quietguy675/RFID_Door_Entry/README.md

# RFID_Door_Entry
Arduino-based system which interacts with an HID reader, a SD card shield, and an electric door strike
