quietguy675/RFID_Door_Entry/RFID_Eagle_Files/RFID/RFID.brd

## EAGLE design RFID_Eagle_Files/RFID/RFID.brd (2017-01-27)

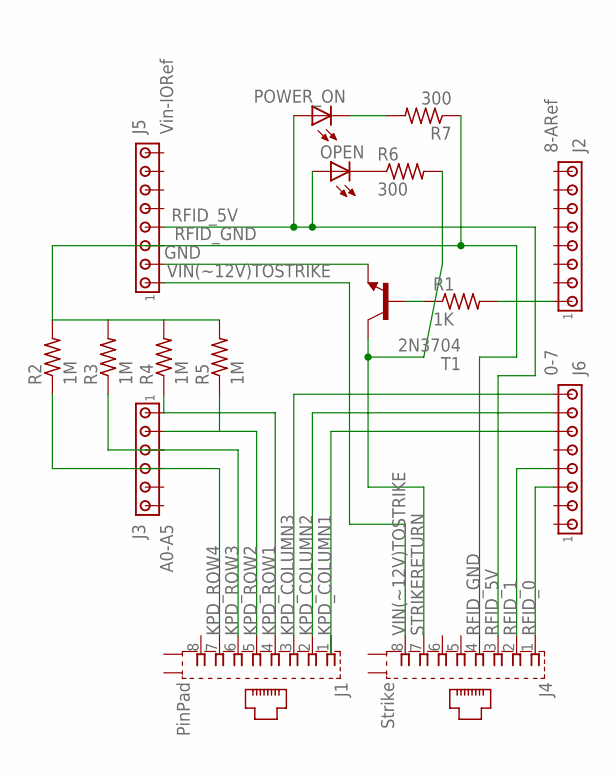
[picture p1: schematic RFID.sch]

Parts:
J1: PinPad; 556591-1
J2: 8-ARef; 1X8MTA
J3: A0-A5; 10X06MTA
J4: Strike; 556591-1
J5: Vin-IORef; 1X8MTA
J6: 0-7; 1X8MTA
OPEN: LED3MM
POWER_ON: LED3MM
R1: 1K; 0204/5
R2, R3, R4, R5: 1M; 0204/5
R6, R7: 300; 0204/5
T1: 2N3704; TO92

Connections:
GND: J5.2, T1.3 (E)
KPD_COLUMN1: J6.6
KPD_COLUMN2: J1.2, J6.7
KPD_COLUMN3: J1.3, J6.8
KPD_ROW1: J1.4, J3.6 (1), R4.1
KPD_ROW2: J1.5, J3.5 (2), R5.1
KPD_ROW3: J1.6, J3.4 (3), R3.1
KPD_ROW4: J1.7, J3.3 (4), R2.1
unnamed: J2.1, R1.2
unnamed: R1.1, T1.1 (B)
unnamed: OPEN.K (C), R6.1
unnamed: POWER_ON.K (C), R7.2
RFID_0: J4.1, J6.3
RFID_1: J4.2, J6.4
RFID_5V: J4.3, J5.4, OPEN.A, POWER_ON.A
RFID_GND: J4.4, J5.3, R2.2, R3.2, R4.2, R5.2, R7.1
STRIKERETURN: J4.7, R6.2, T1.2 (C)
VIN(~12V)TOSTRIKE: J4.8, J5.1

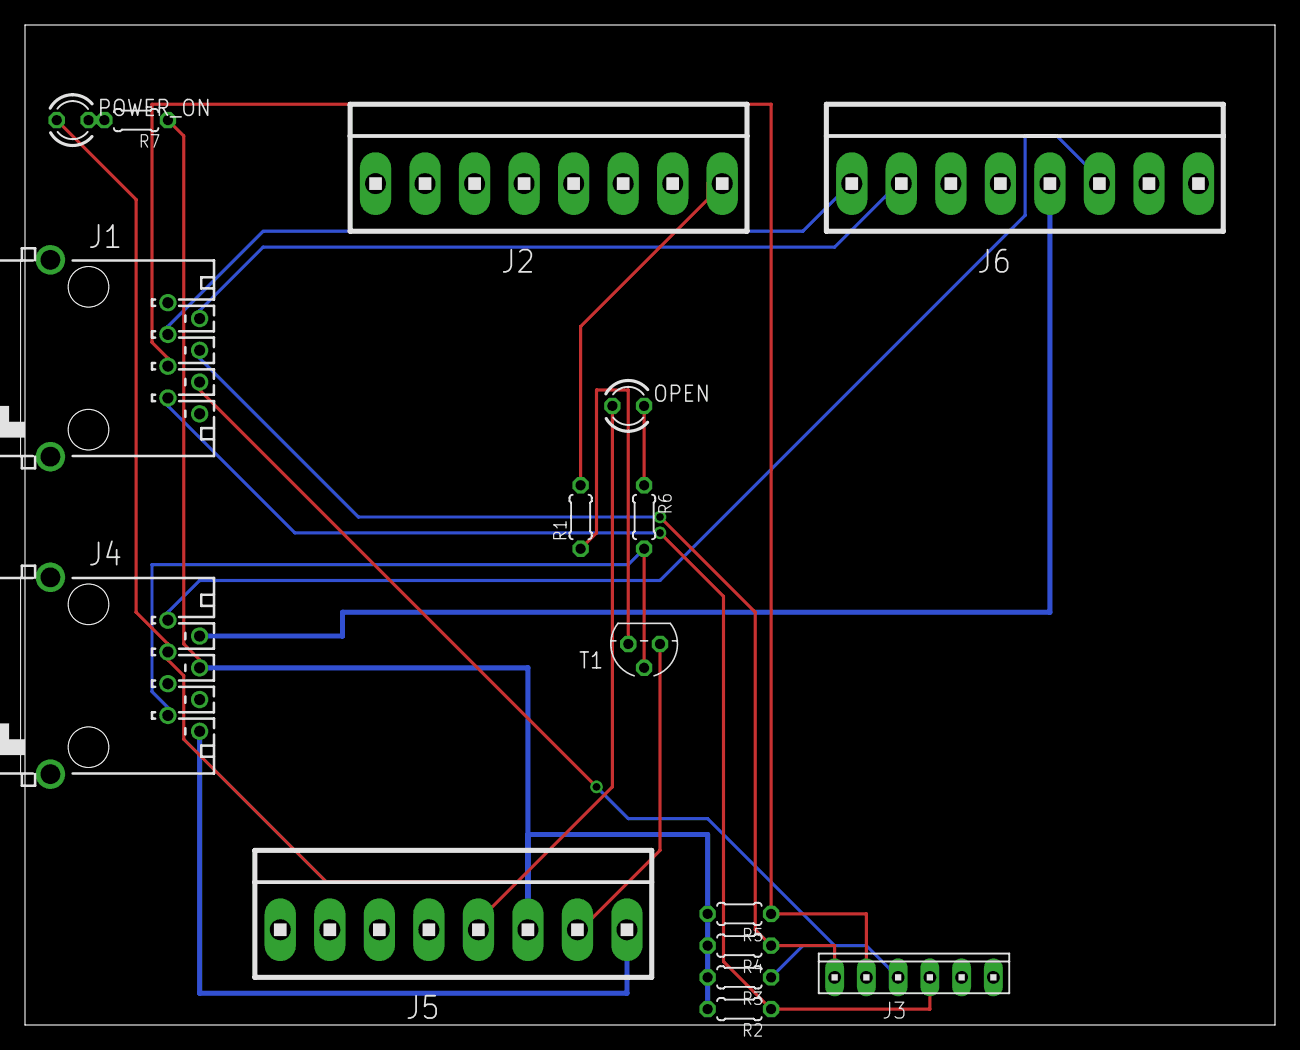
[picture p2: board RFID.brd from above]

Board: 2 copper layers, 100.0 x 80.0 mm, 16 parts (0 on the bottom side), 17 nets.
