quietguy675/RFID_Door_Entry/RFID Quick Guide.docx

RFID Door Quick Guide

Timeout – 30 seconds

Green – Ready to Scan

Red – Open Door

Yellow – Delete Mode

Purple – Program Mode

Dis/Enable Delete Mode - 2013

Dis/Enable Program Mode - 1924

See Delta for Details
